omarmustafa130/Logic-Controlled-LED-Driver-PCB/Screenshots/Screenshot 2025-03-14 121610.png

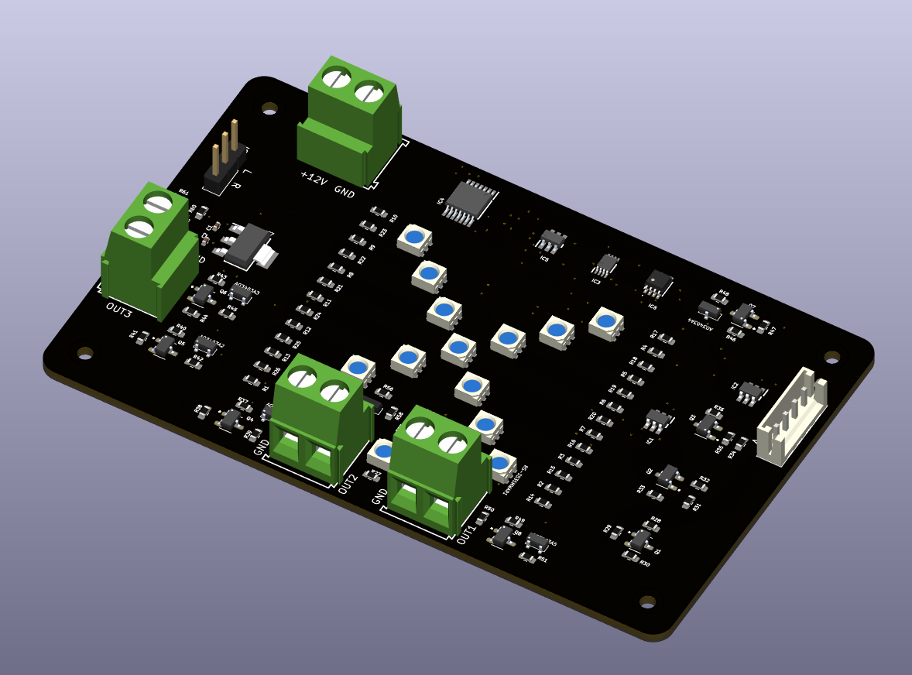
Screenshots/Screenshot 2025-03-14 121610.png
