omarmustafa130/Logic-Controlled-LED-Driver-PCB/Additional footprints, symbols, & 3D models/3D models/smd-3535rgb-led-1.snapshot.3/2.JPG

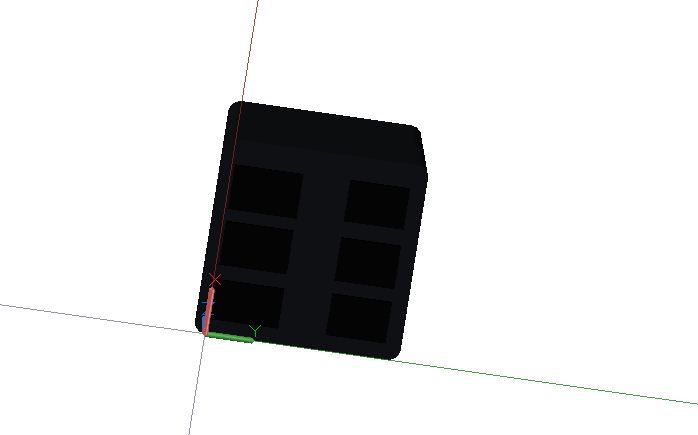
Additional footprints, symbols, & 3D models/3D models/smd-3535rgb-led-1.snapshot.3/2.JPG
