omarmustafa130/Logic-Controlled-LED-Driver-PCB/Additional footprints, symbols, & 3D models/3D models/smd_3535rgb_led_6_pin_0314055144_texture_obj/smd_3535rgb_led_6_pin_0314055144_texture_obj/smd_3535rgb_led_6_pin_0314055144_texture.png

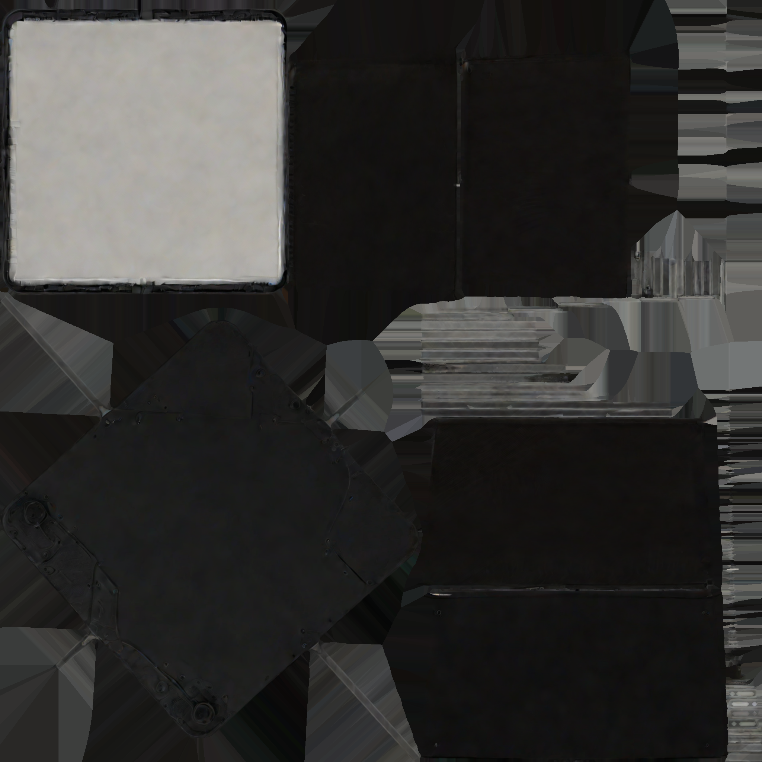
Additional footprints, symbols, & 3D models/3D models/smd_3535rgb_led_6_pin_0314055144_texture_obj/smd_3535rgb_led_6_pin_0314055144_texture_obj/smd_3535rgb_led_6_pin_0314055144_texture.png
