omarmustafa130/Logic-Controlled-LED-Driver-PCB/Fabrication Outputs/BOM/MOSFET Controller BOM.csv

# | Reference | Value | JLCPCB Part # | Package | Footprint | Description_1 | Datasheet | MANUFACTURER | Manufacturer_Name | Manufacturer_Part_Number | Mouser Part Number | Price
1 | AO3403A1 | AO3403A | C545577 | SOT-23-3 | MOSFET_CONTROLLER_LIB:AO3403A
2 | AO3403A2 | AO3403A | C545577 | SOT-23-3 | MOSFET_CONTROLLER_LIB:AO3403A
3 | AO3403A3 | AO3403A | C545577 | SOT-23-3 | MOSFET_CONTROLLER_LIB:AO3403A
4 | AO3403A4 | AO3403A | C545577 | SOT-23-3 | MOSFET_CONTROLLER_LIB:AO3403A
5 | AO3403A5 | AO3403A | C545577 | SOT-23-3 | MOSFET_CONTROLLER_LIB:AO3403A
6 | AO3403A6 | AO3403A | C545577 | SOT-23-3 | MOSFET_CONTROLLER_LIB:AO3403A
7 | AO3403A7 | AO3403A | C545577 | SOT-23-3 | MOSFET_CONTROLLER_LIB:AO3403A
8 | AO3403A8 | AO3403A | C545577 | SOT-23-3 | MOSFET_CONTROLLER_LIB:AO3403A
9 | C1 | 0.22u | C16651 | 402 | Capacitor_SMD:C_0402_1005Metric |  | ~
10 | C2 | 0.1u | C1525 | 402 | Capacitor_SMD:C_0402_1005Metric |  | ~
11 | IC1 | SN74LVC2G04DBVR | C10428 | SOT-23-6 | MOSFET_CONTROLLER_LIB:SOT95P280X145-6N |  | http://www.ti.com/lit/gpn/sn74lvc2g04 |  | Texas Instruments | SN74LVC2G04DBVR | 595-SN74LVC2G04DBVR
12 | IC2 | SN74LVC2G04DBVR | C10428 | SOT-23-6 | MOSFET_CONTROLLER_LIB:SOT95P280X145-6N |  | http://www.ti.com/lit/gpn/sn74lvc2g04 |  | Texas Instruments | SN74LVC2G04DBVR | 595-SN74LVC2G04DBVR
13 | IC3 | SN74LVC2G32DCUR | C91874 | VSSOP-8-0.5mm | MOSFET_CONTROLLER_LIB:SOP50P310X90-8N |  | https://www.ti.com/lit/ds/symlink/sn74lvc2g32.pdf?ts=1619327696294 |  | Texas Instruments | SN74LVC2G32DCURG4 | 595-74LVC2G32DCURG4
14 | IC4 | CD74HCT11M96 | C6553 | SOIC-14 | SOIC127P600X175-14N |  | http://www.ti.com/lit/gpn/cd74hct11 |  | Texas Instruments | CD74HCT11M96 | 595-CD74HCT11M96
15 | IC5 | SN74LVC1G11DCKR | C529281 | SC-70-6 | MOSFET_CONTROLLER_LIB:SOT95P275X110-6N |  | https://www.onsemi.com/pub/Collateral/NL17SZ11-D.PDF |  | onsemi | NL17SZ11DBVT1G | 863-NL17SZ11DBVT1G
16 | IC6 | TC7WH08FU,LJ(CT | C2880450 | SSOP-8-2.8mm | MOSFET_CONTROLLER_LIB:TC7W53FUF |  | https://toshiba.semicon-storage.com/info/docget.jsp?did=20199&prodName=TC7W08FU |  | Toshiba | TC7W08FU | 757-TC7W08FU
17 | IC7 | LM7805MPX/NOPB | C2848241 | SOT-223-4 | MOSFET_CONTROLLER_LIB:SOT230P700X180-4N |  | https://www.arrow.com/en/products/lm7805mpxnopb/texas-instruments |  | Texas Instruments | LM7805MPX/NOPB | 595-LM7805MPX/NOPB
18 | J1 | B4B-XH-A(LF)(SN) | C144395 | Plugin,P=2.5mm | MOSFET_CONTROLLER_LIB:SHDRV4W111P0_250_1X4_1250X380X600P |  | https://datasheet.datasheetarchive.com/originals/distributors/Datasheets_SAMA/4db6e353008cd822f9644e9913ed09f5.pdf |  | JST (JAPAN SOLDERLESS TERMINALS) | B4B-EH-A(LF)(SN) | 306-B4BEHALFSN
19 | J2 | WJ127-5.0-2P | C3703 | Plugin,P=5mm | MOSFET_CONTROLLER_LIB:691216510002S | 2 Position Wire to Board Terminal Block Horizontal with Board 0.200 (5.08mm) Through Hole |  |  |  |  |  | None
20 | J3 | WJ127-5.0-2P | C3703 | Plugin,P=5mm | MOSFET_CONTROLLER_LIB:691216510002S | 2 Position Wire to Board Terminal Block Horizontal with Board 0.200 (5.08mm) Through Hole |  |  |  |  |  | None
21 | J4 | WJ127-5.0-2P | C3703 | Plugin,P=5mm | MOSFET_CONTROLLER_LIB:691216510002S | 2 Position Wire to Board Terminal Block Horizontal with Board 0.200 (5.08mm) Through Hole |  |  |  |  |  | None
22 | J5 | Conn_01x03_Pin | C49257 | Plugin,P=5mm | Connector_PinHeader_2.54mm:PinHeader_1x03_P2.54mm_Vertical |  | ~
23 | J6 | WJ127-5.0-2P | C3703 | Plugin,P=5mm | MOSFET_CONTROLLER_LIB:691216510002S | 2 Position Wire to Board Terminal Block Horizontal with Board 0.200 (5.08mm) Through Hole |  |  |  |  |  | None
24 | R1 | 100R | C22775 | 603 | Resistor_SMD:R_0603_1608Metric |  | ~
25 | R2 | 100R | C22775 | 603 | Resistor_SMD:R_0603_1608Metric |  | ~
26 | R3 | 100R | C22775 | 603 | Resistor_SMD:R_0603_1608Metric |  | ~
27 | R4 | 100R | C22775 | 603 | Resistor_SMD:R_0603_1608Metric |  | ~
28 | R5 | 100R | C22775 | 603 | Resistor_SMD:R_0603_1608Metric |  | ~
29 | R6 | 100R | C22775 | 603 | Resistor_SMD:R_0603_1608Metric |  | ~
30 | R7 | 100R | C22775 | 603 | Resistor_SMD:R_0603_1608Metric |  | ~
31 | R8 | 100R | C22775 | 603 | Resistor_SMD:R_0603_1608Metric |  | ~
32 | R9 | 100R | C22775 | 603 | Resistor_SMD:R_0603_1608Metric |  | ~
33 | R10 | 100R | C22775 | 603 | Resistor_SMD:R_0603_1608Metric |  | ~
34 | R11 | 100R | C22775 | 603 | Resistor_SMD:R_0603_1608Metric |  | ~
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
93 | RS-3535MWAR7 | RS-3535MWAR | C110402 | SMD3535 | MOSFET_CONTROLLER_LIB:RS-3535MWAR
94 | RS-3535MWAR8 | RS-3535MWAR | C110402 | SMD3535 | MOSFET_CONTROLLER_LIB:RS-3535MWAR
95 | RS-3535MWAR9 | RS-3535MWAR | C110402 | SMD3535 | MOSFET_CONTROLLER_LIB:RS-3535MWAR
96 | RS-3535MWAR10 | RS-3535MWAR | C110402 | SMD3535 | MOSFET_CONTROLLER_LIB:RS-3535MWAR
97 | RS-3535MWAR11 | RS-3535MWAR | C110402 | SMD3535 | MOSFET_CONTROLLER_LIB:RS-3535MWAR
98 | RS-3535MWAR12 | RS-3535MWAR | C110402 | SMD3535 | MOSFET_CONTROLLER_LIB:RS-3535MWAR
99 | RS-3535MWAR13 | RS-3535MWAR | C110402 | SMD3535 | MOSFET_CONTROLLER_LIB:RS-3535MWAR
100 | RS-3535MWAR14 | RS-3535MWAR | C110402 | SMD3535 | MOSFET_CONTROLLER_LIB:RS-3535MWAR
101 | Q1 | AO3400A | C20917 | SOT-23-3L | MOSFET_CONTROLLER_LIB:AO3403A | N-Channel 30 V 5.7A (Ta) 1.4W (Ta) Surface Mount SOT-23-3 |  | Alpha & Omega Semiconductor |  |  |  | None
102 | Q2 | AO3400A | C20917 | SOT-23-3L | MOSFET_CONTROLLER_LIB:AO3403A | N-Channel 30 V 5.7A (Ta) 1.4W (Ta) Surface Mount SOT-23-3 |  | Alpha & Omega Semiconductor |  |  |  | None
103 | Q3 | AO3400A | C20917 | SOT-23-3L | MOSFET_CONTROLLER_LIB:AO3403A | N-Channel 30 V 5.7A (Ta) 1.4W (Ta) Surface Mount SOT-23-3 |  | Alpha & Omega Semiconductor |  |  |  | None
104 | Q4 | AO3400A | C20917 | SOT-23-3L | MOSFET_CONTROLLER_LIB:AO3403A | N-Channel 30 V 5.7A (Ta) 1.4W (Ta) Surface Mount SOT-23-3 |  | Alpha & Omega Semiconductor |  |  |  | None
105 | Q5 | AO3400A | C20917 | SOT-23-3L | MOSFET_CONTROLLER_LIB:AO3403A | N-Channel 30 V 5.7A (Ta) 1.4W (Ta) Surface Mount SOT-23-3 |  | Alpha & Omega Semiconductor |  |  |  | None
106 | Q6 | AO3400A | C20917 | SOT-23-3L | MOSFET_CONTROLLER_LIB:AO3403A | N-Channel 30 V 5.7A (Ta) 1.4W (Ta) Surface Mount SOT-23-3 |  | Alpha & Omega Semiconductor |  |  |  | None
107 | Q7 | AO3400A | C20917 | SOT-23-3L | MOSFET_CONTROLLER_LIB:AO3403A | N-Channel 30 V 5.7A (Ta) 1.4W (Ta) Surface Mount SOT-23-3 |  | Alpha & Omega Semiconductor |  |  |  | None
108 | Q8 | AO3400A | C20917 | SOT-23-3L | MOSFET_CONTROLLER_LIB:AO3403A | N-Channel 30 V 5.7A (Ta) 1.4W (Ta) Surface Mount SOT-23-3 |  | Alpha & Omega Semiconductor |  |  |  | None
109 | Q9 | AO3400A | C20917 | SOT-23-3L | MOSFET_CONTROLLER_LIB:AO3403A | N-Channel 30 V 5.7A (Ta) 1.4W (Ta) Surface Mount SOT-23-3 |  | Alpha & Omega Semiconductor |  |  |  | None
110 | Q10 | AO3400A | C20917 | SOT-23-3L | MOSFET_CONTROLLER_LIB:AO3403A | N-Channel 30 V 5.7A (Ta) 1.4W (Ta) Surface Mount SOT-23-3 |  | Alpha & Omega Semiconductor |  |  |  | None
111 | Q11 | AO3400A | C20917 | SOT-23-3L | MOSFET_CONTROLLER_LIB:AO3403A | N-Channel 30 V 5.7A (Ta) 1.4W (Ta) Surface Mount SOT-23-3 |  | Alpha & Omega Semiconductor |  |  |  | None
