omarmustafa130/Logic-Controlled-LED-Driver-PCB/Additional footprints, symbols, & 3D models/3D models/smd_3535rgb_led_6_pin_0314055239_texture.stl

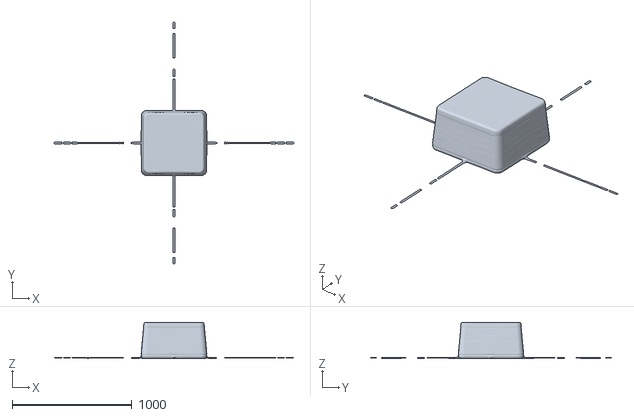
[picture p10: CAD file, 2025-03-16]
Additional footprints, symbols, & 3D models/3D models/smd_3535rgb_led_6_pin_0314055239_texture.stl
2004.7 x 2017.8 x 304.4
