omarmustafa130/Logic-Controlled-LED-Driver-PCB/Additional footprints, symbols, & 3D models/74HCT11PW/LIB_74HCT11PW,118/74HCT11PW,118/3D/74HCT11PW,118.stp

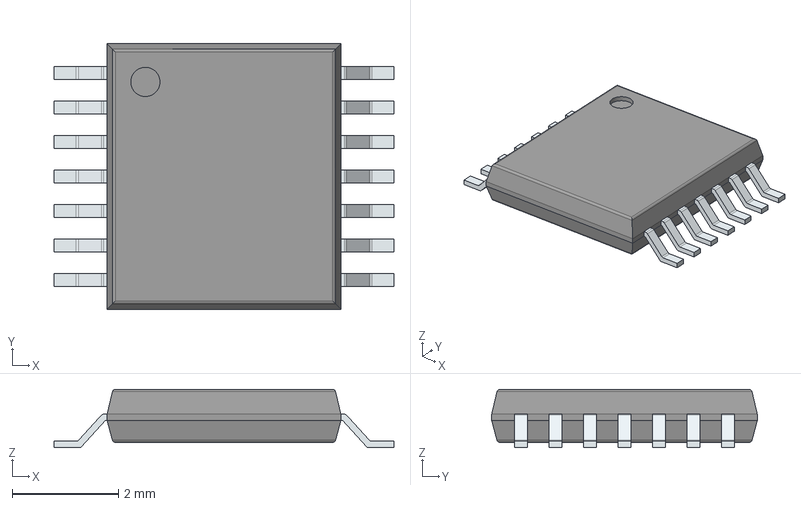
[picture p11: CAD file, 2025-03-16]
Additional footprints, symbols, & 3D models/74HCT11PW/LIB_74HCT11PW,118/74HCT11PW,118/3D/74HCT11PW,118.stp
6.40 x 5.00 x 1.10 mm
PinsArrayLR
