omarmustafa130/Logic-Controlled-LED-Driver-PCB/Additional footprints, symbols, & 3D models/7805/LIB_LM7805MPX_NOPB/LM7805MPX_NOPB/3D/LM7805MPX_NOPB.stp

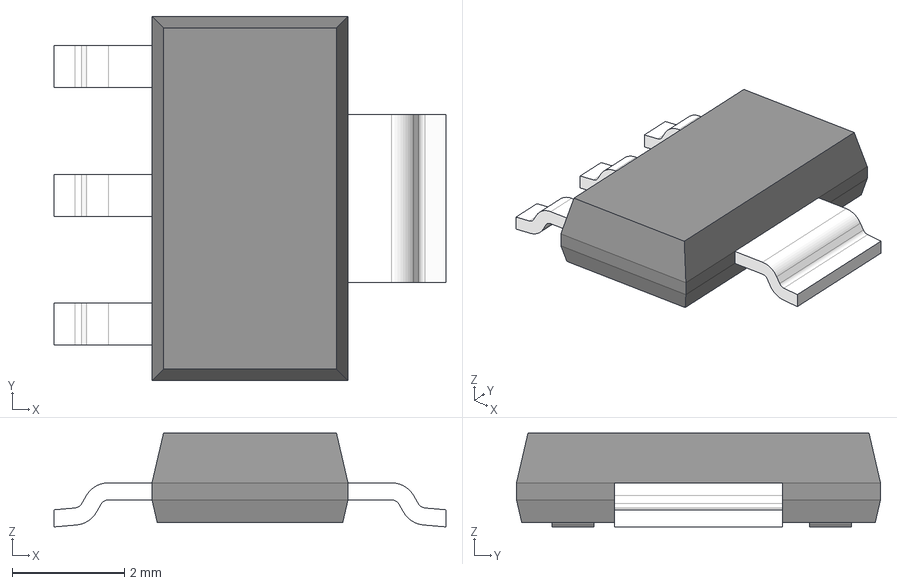
[picture p12: CAD file, 2025-03-16]
Additional footprints, symbols, & 3D models/7805/LIB_LM7805MPX_NOPB/LM7805MPX_NOPB/3D/LM7805MPX_NOPB.stp
7.00 x 6.50 x 1.68 mm
BODY-SOT
LEAD-SOT x 3
LEAD-SOT-WIDE
PIN1-ID
