omarmustafa130/Logic-Controlled-LED-Driver-PCB/Additional footprints, symbols, & 3D models/AO3400A/AO3400A/AO3400A.step

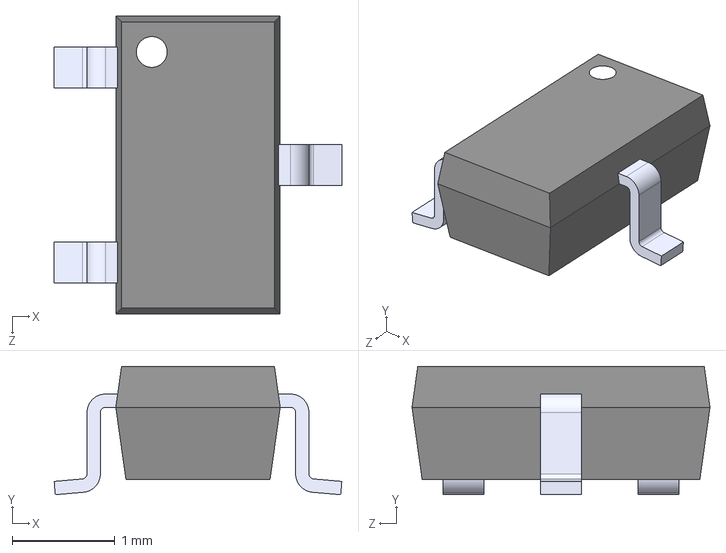
[picture p13: CAD file, 2025-03-16]
Additional footprints, symbols, & 3D models/AO3400A/AO3400A/AO3400A.step
2.80 x 1.25 x 2.90 mm
