omarmustafa130/Logic-Controlled-LED-Driver-PCB/Additional footprints, symbols, & 3D models/B4B-EH-A(LF)(SN)/LIB_B4B-EH-A_LF__SN_/B4B-EH-A_LF__SN_/3D/B4B-EH-A_LF__SN_.stp

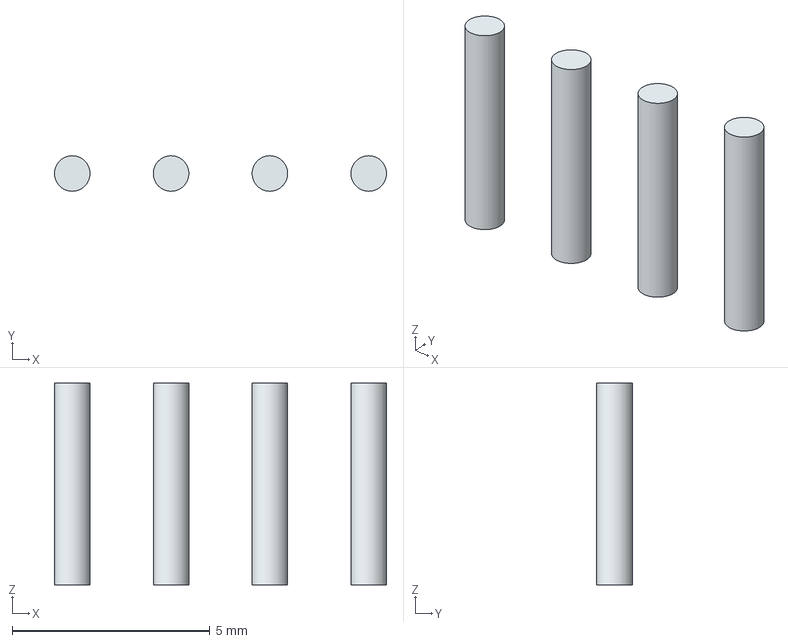
[picture p14: CAD file, 2025-03-16]
Additional footprints, symbols, & 3D models/B4B-EH-A(LF)(SN)/LIB_B4B-EH-A_LF__SN_/B4B-EH-A_LF__SN_/3D/B4B-EH-A_LF__SN_.stp
8.40 x 0.9 x 5.10 mm
Leads x 4
