omarmustafa130/Logic-Controlled-LED-Driver-PCB/Additional footprints, symbols, & 3D models/CD74HCT11M96/LIB_CD74HCT11M96/CD74HCT11M96/3D/CD74HCT11M96.stp

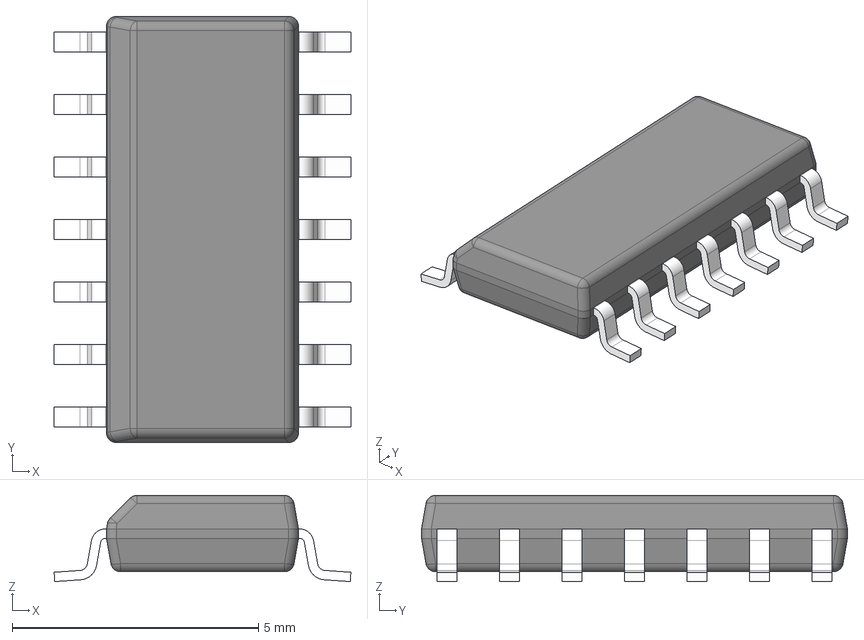
[picture p15: CAD file, 2025-03-16]
Additional footprints, symbols, & 3D models/CD74HCT11M96/LIB_CD74HCT11M96/CD74HCT11M96/3D/CD74HCT11M96.stp
6.03 x 8.65 x 1.75 mm
BODY-SO
LEAD-SO x 14
PIN1-ID
