omarmustafa130/Logic-Controlled-LED-Driver-PCB/Additional footprints, symbols, & 3D models/NL17SZ11DBVT1G/LIB_NL17SZ11DBVT1G/NL17SZ11DBVT1G/3D/NL17SZ11DBVT1G.stp

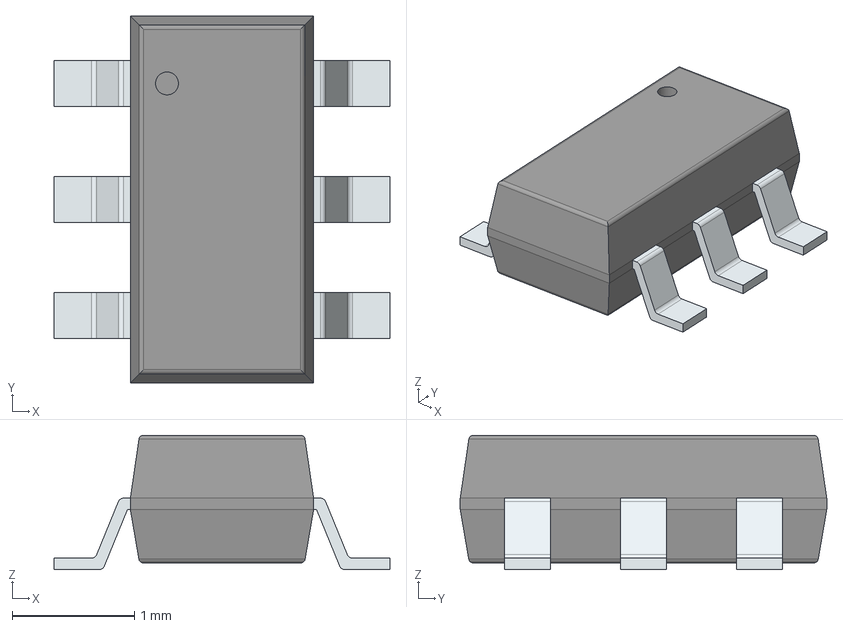
[picture p16: CAD file, 2025-03-16]
Additional footprints, symbols, & 3D models/NL17SZ11DBVT1G/LIB_NL17SZ11DBVT1G/NL17SZ11DBVT1G/3D/NL17SZ11DBVT1G.stp
2.75 x 3.00 x 1.10 mm
PinsArrayLR
