omarmustafa130/Logic-Controlled-LED-Driver-PCB/Additional footprints, symbols, & 3D models/SN74LVC2G04DBVR/LIB_SN74LVC2G04DBVR/SN74LVC2G04DBVR/3D/SN74LVC2G04DBVR.stp

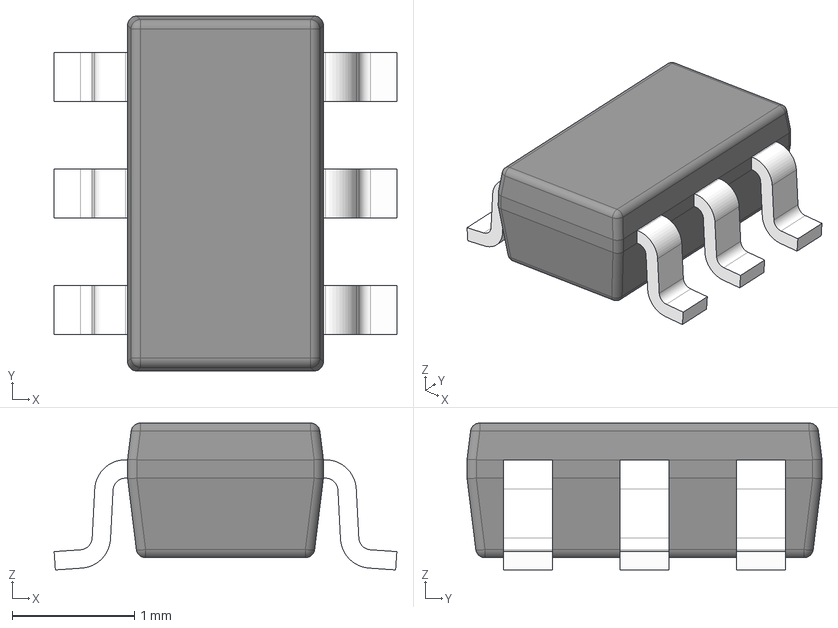
[picture p17: CAD file, 2025-03-16]
Additional footprints, symbols, & 3D models/SN74LVC2G04DBVR/LIB_SN74LVC2G04DBVR/SN74LVC2G04DBVR/3D/SN74LVC2G04DBVR.stp
2.80 x 2.90 x 1.20 mm
BODY-SOT
LEAD-SOT x 6
