omarmustafa130/Logic-Controlled-LED-Driver-PCB/Additional footprints, symbols, & 3D models/SN74LVC2G32DCURG4/LIB_SN74LVC2G32DCURG4/SN74LVC2G32DCURG4/3D/SN74LVC2G32DCURG4.stp

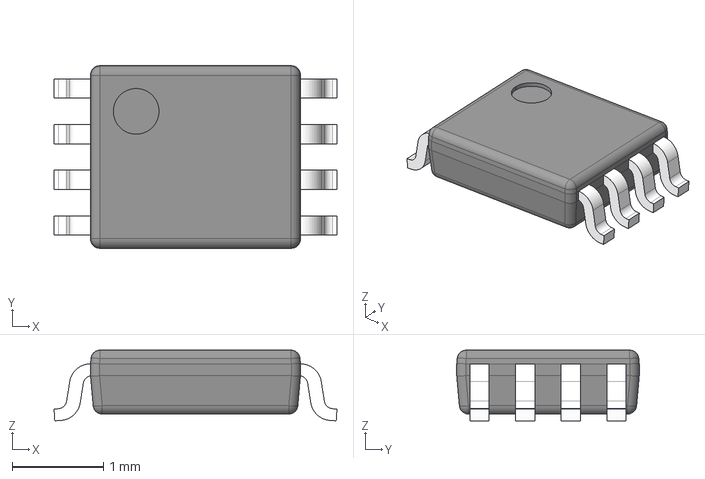
[picture p18: CAD file, 2025-03-16]
Additional footprints, symbols, & 3D models/SN74LVC2G32DCURG4/LIB_SN74LVC2G32DCURG4/SN74LVC2G32DCURG4/3D/SN74LVC2G32DCURG4.stp
3.10 x 2.00 x 0.775 mm
BODY-VSSOP
LEAD-VSSOP x 8
