omarmustafa130/Logic-Controlled-LED-Driver-PCB/Additional footprints, symbols, & 3D models/TC7W08FU/LIB_TC7W08FU/TC7W08FU/3D/TC7W08FU.stp

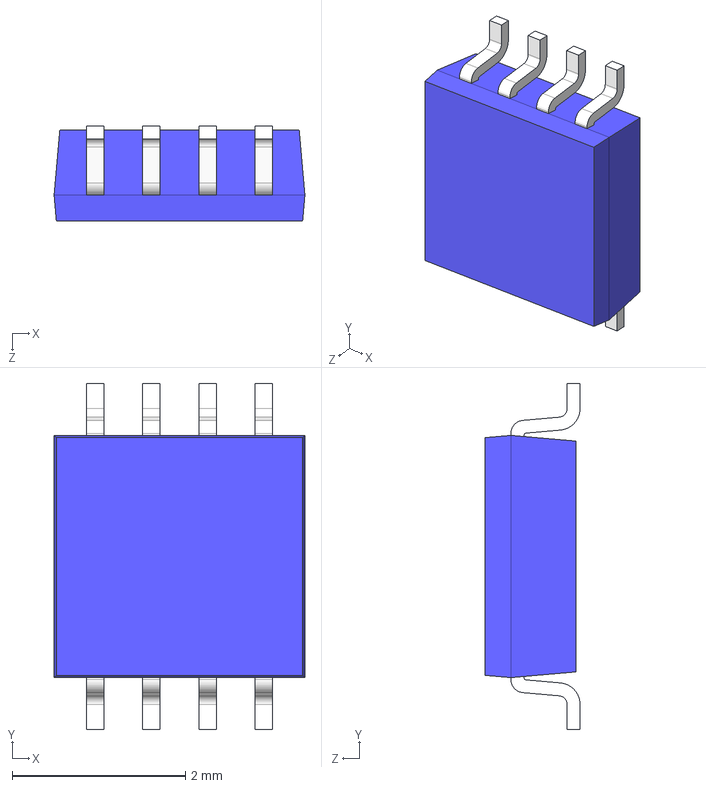
[picture p19: CAD file, 2025-03-16]
Additional footprints, symbols, & 3D models/TC7W08FU/LIB_TC7W08FU/TC7W08FU/3D/TC7W08FU.stp
2.90 x 4.00 x 1.10 mm
