omarmustafa130/Logic-Controlled-LED-Driver-PCB/Additional footprints, symbols, & 3D models/3D models/smd_3535rgb_led_6_pin_0314060435_texture.stl

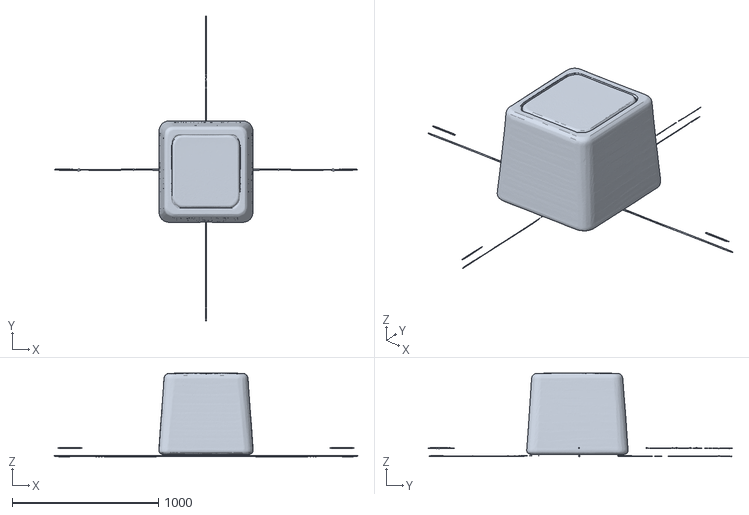
[picture p20: CAD file, 2025-03-16]
Additional footprints, symbols, & 3D models/3D models/smd_3535rgb_led_6_pin_0314060435_texture.stl
2080.1 x 2087.7 x 574.4
