omarmustafa130/Logic-Controlled-LED-Driver-PCB/Additional footprints, symbols, & 3D models/PCB Terminal Block/691216510002S/691216510002S.step

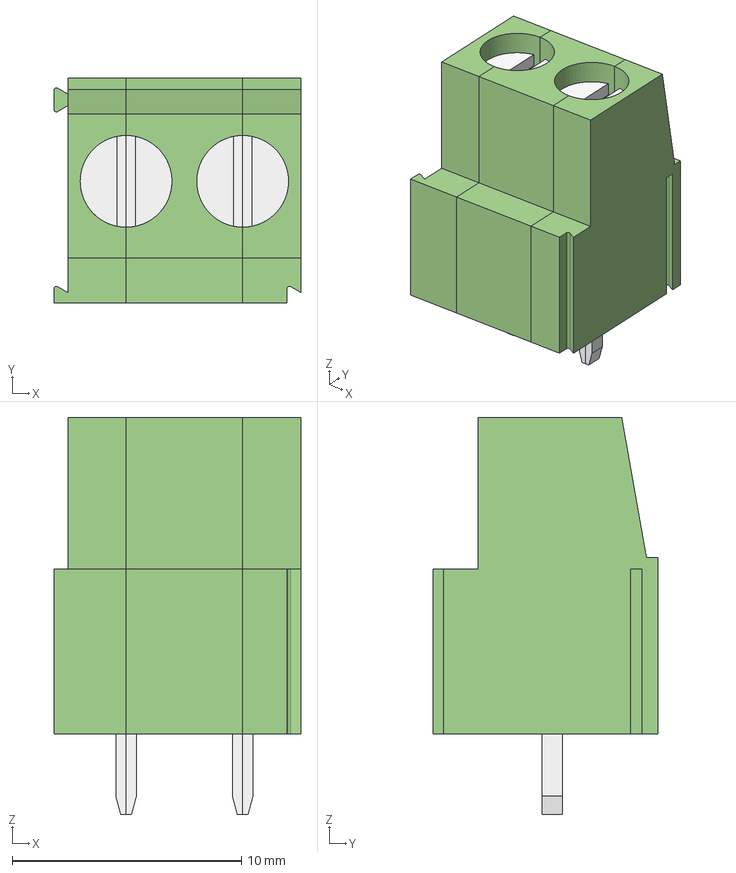
[picture p21: CAD file, 2025-03-16]
Additional footprints, symbols, & 3D models/PCB Terminal Block/691216510002S/691216510002S.step
10.8 x 9.80 x 17.3 mm
CLL5.08_DX
CLL5.08_CNT
CLL5.08_SX
