omarmustafa130/Logic-Controlled-LED-Driver-PCB/(list of files, cad)

Other CAD files:
Additional footprints, symbols, & 3D models/3D models/smd-3535rgb-led-1.snapshot.3/3535RGB.dwg
Additional footprints, symbols, & 3D models/74HCT11PW/LIB_74HCT11PW,118/74HCT11PW,118/Allegro/sop65p640x110-14n.psm
Additional footprints, symbols, & 3D models/74HCT11PW/LIB_74HCT11PW,118/74HCT11PW,118/DEHDL/74hct11pw_118/chips/chips.prt
Additional footprints, symbols, & 3D models/7805/LIB_LM7805MPX_NOPB/LM7805MPX_NOPB/Allegro/sot230p700x180-4n.psm
Additional footprints, symbols, & 3D models/7805/LIB_LM7805MPX_NOPB/LM7805MPX_NOPB/DEHDL/lm7805mpx_nopb/chips/chips.prt
Additional footprints, symbols, & 3D models/B4B-EH-A(LF)(SN)/LIB_B4B-EH-A_LF__SN_/B4B-EH-A_LF__SN_/Allegro/shdrv4w111p0_250_1x4_1250x380x600p.psm
Additional footprints, symbols, & 3D models/B4B-EH-A(LF)(SN)/LIB_B4B-EH-A_LF__SN_/B4B-EH-A_LF__SN_/DEHDL/b4b_eh_a_lf__sn_/chips/chips.prt
Additional footprints, symbols, & 3D models/CD74HCT11M96/LIB_CD74HCT11M96/CD74HCT11M96/Allegro/soic127p600x175-14n.psm
Additional footprints, symbols, & 3D models/CD74HCT11M96/LIB_CD74HCT11M96/CD74HCT11M96/DEHDL/cd74hct11m96/chips/chips.prt
Additional footprints, symbols, & 3D models/NL17SZ11DBVT1G/LIB_NL17SZ11DBVT1G/NL17SZ11DBVT1G/Allegro/sot95p275x110-6n.psm
Additional footprints, symbols, & 3D models/NL17SZ11DBVT1G/LIB_NL17SZ11DBVT1G/NL17SZ11DBVT1G/DEHDL/nl17sz11dbvt1g/chips/chips.prt
Additional footprints, symbols, & 3D models/SN74LVC2G04DBVR/LIB_SN74LVC2G04DBVR/SN74LVC2G04DBVR/Allegro/sot95p280x145-6n.psm
Additional footprints, symbols, & 3D models/SN74LVC2G04DBVR/LIB_SN74LVC2G04DBVR/SN74LVC2G04DBVR/DEHDL/sn74lvc2g04dbvr/chips/chips.prt
Additional footprints, symbols, & 3D models/SN74LVC2G32DCURG4/LIB_SN74LVC2G32DCURG4/SN74LVC2G32DCURG4/Allegro/sop50p310x90-8n.psm
Additional footprints, symbols, & 3D models/SN74LVC2G32DCURG4/LIB_SN74LVC2G32DCURG4/SN74LVC2G32DCURG4/DEHDL/sn74lvc2g32dcurg4/chips/chips.prt
Additional footprints, symbols, & 3D models/TC7W08FU/LIB_TC7W08FU/TC7W08FU/Allegro/tc7w53fuf.psm
Additional footprints, symbols, & 3D models/TC7W08FU/LIB_TC7W08FU/TC7W08FU/DEHDL/tc7w08fu/chips/chips.prt
