omarmustafa130/Logic-Controlled-LED-Driver-PCB/Schematics/Schematics.pdf

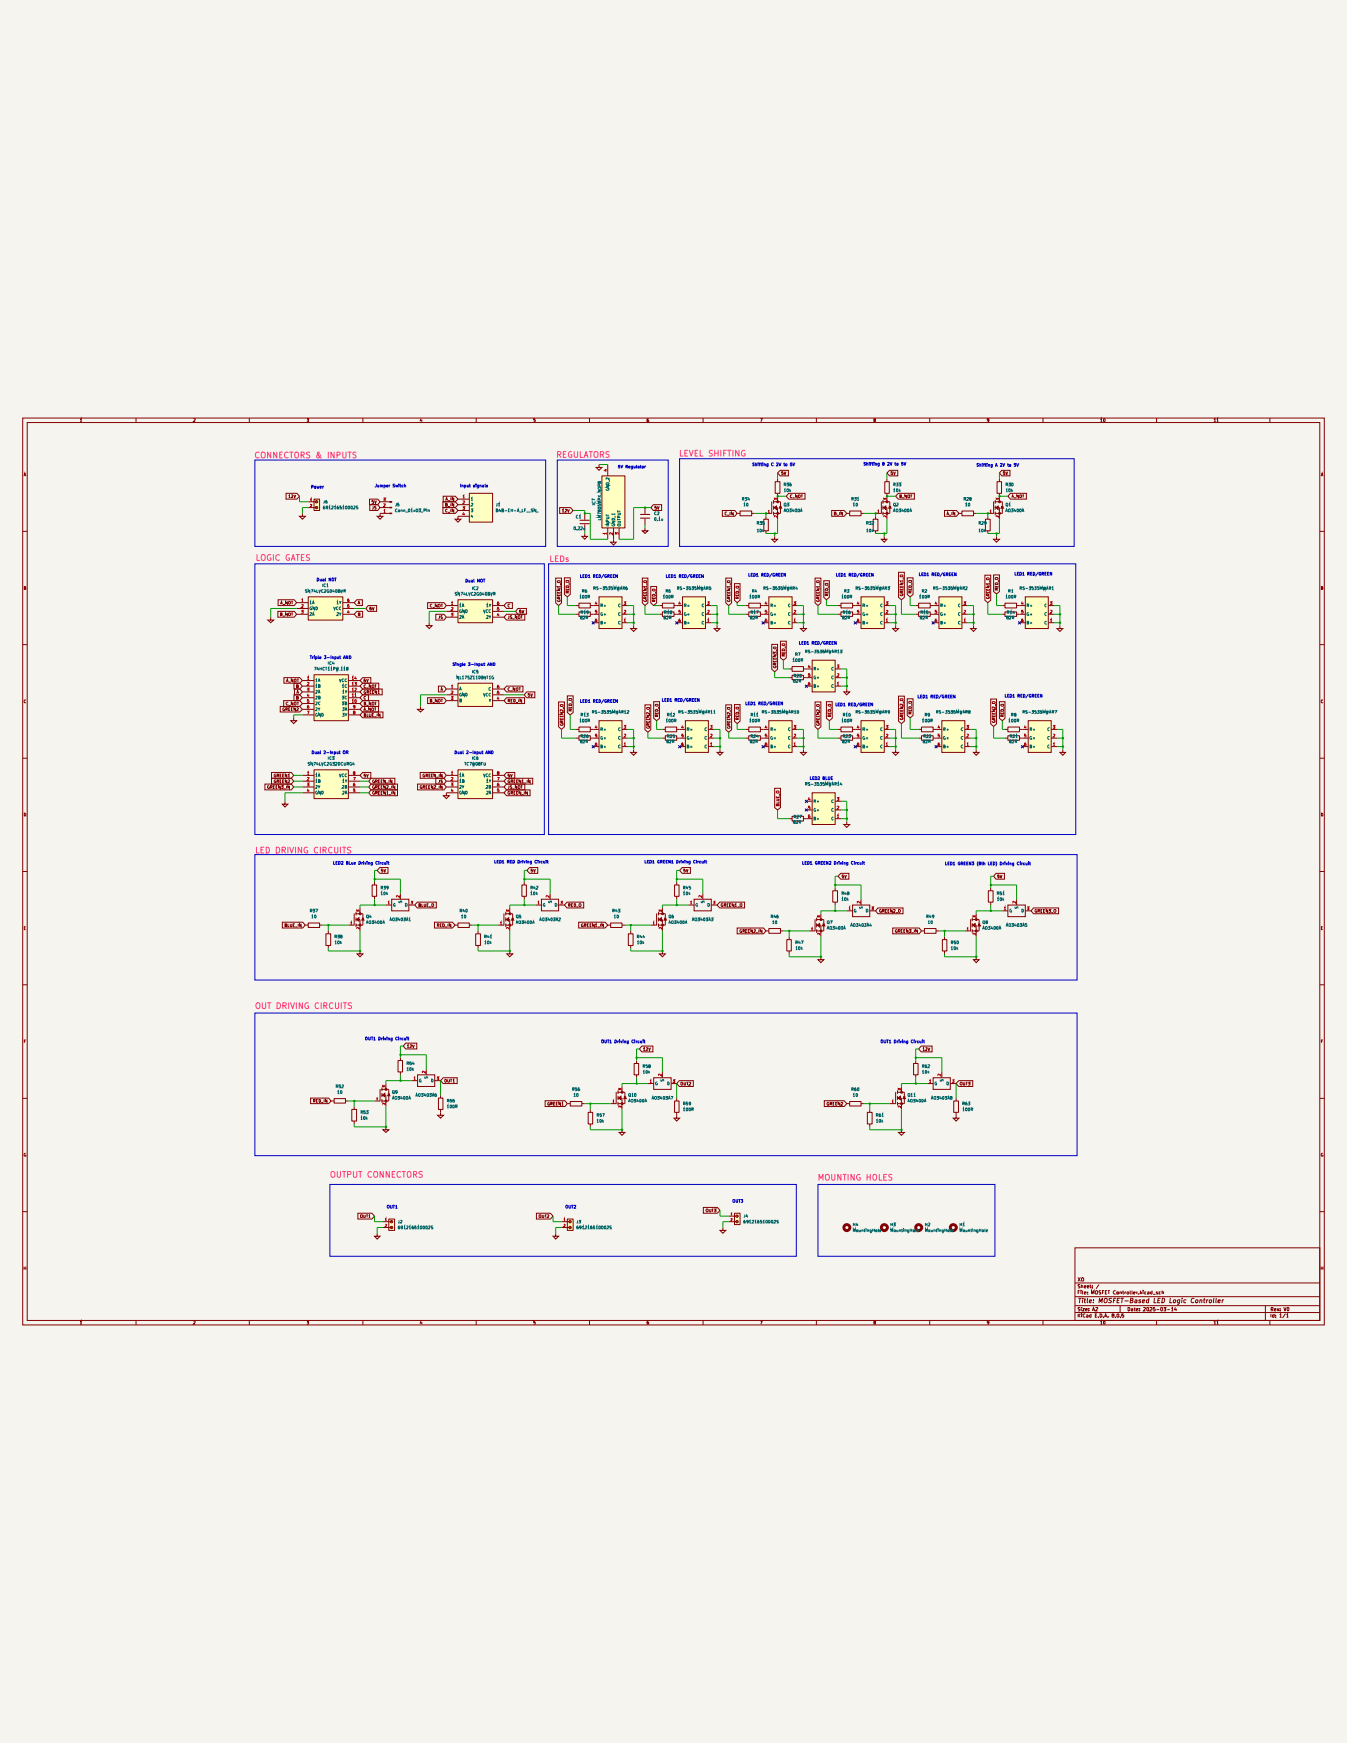
[picture p22: page 1]
