omarmustafa130/Logic-Controlled-LED-Driver-PCB/(list of files, drawings)

Other design files:
Simulation/MOSFET_CONTROLLER.pdsprj
Simulation/Project Backups/MOSFET_CONTROLLER [20250313, 23-41-58].pdsprj
Simulation/Project Backups/MOSFET_CONTROLLER [20250314, 00-18-40].pdsprj
Simulation/Project Backups/MOSFET_CONTROLLER [20250314, 00-28-29].pdsprj
Simulation/Project Backups/MOSFET_CONTROLLER [20250314, 00-48-38].pdsprj
Simulation/Project Backups/MOSFET_CONTROLLER [20250314, 01-27-56].pdsprj
Simulation/Project Backups/MOSFET_CONTROLLER [20250314, 04-41-20].pdsprj
Simulation/Project Backups/MOSFET_CONTROLLER [20250314, 09-30-05].pdsprj
Simulation/Project Backups/MOSFET_CONTROLLER [20250314, 09-30-11].pdsprj
Simulation/Project Backups/MOSFET_CONTROLLER [20250314, 10-53-27].pdsprj
Simulation/Project Backups/MOSFET_CONTROLLER [20250314, 11-33-43].pdsprj
