omarmustafa130/Logic-Controlled-LED-Driver-PCB/MOSFET Controller/MOSFET Controller.kicad_pcb

## KiCad design MOSFET Controller/MOSFET Controller.kicad_pcb (2025-03-16)

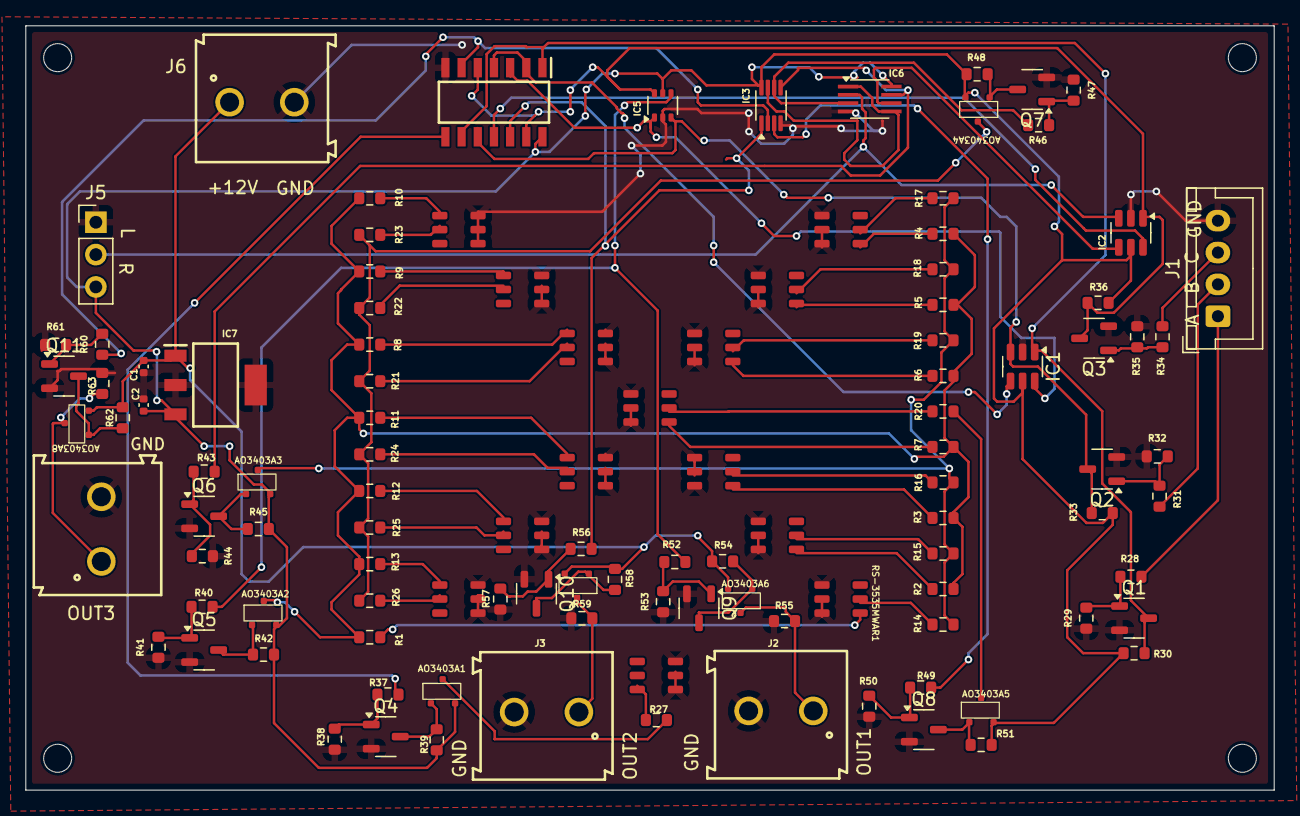
[picture p23: board MOSFET Controller.kicad_pcb from above]

Board: 2 copper layers, 98.0 x 60.0 mm, 115 parts (0 on the bottom side), 76 nets.

Parts:
AO3403A1, AO3403A2, AO3403A3, AO3403A4, AO3403A5, AO3403A6, AO3403A7, AO3403A8: AO3403A
C1: 0.22u; C_0402_1005Metric
C2: 0.1u; C_0402_1005Metric
H1, H2, H3, H4: MountingHole; MountingHole_2.2mm_M2
IC1, IC2: SN74LVC2G04DBVR; SOT-23-6
IC3: SN74LVC2G32DCURG4; VSSOP-8_2.3x2mm_P0.5mm
IC4: 74HCT11PW,118; SOIC127P600X175-14N - IC4
IC5: NL17SZ11DBVT1G; SOT-363_SC-70-6
IC6: TC7W08FU; SSOP-8_2.95x2.8mm_P0.65mm
IC7: LM7805MPX_NOPB; SOT230P700X180-4N
J1: B4B-EH-A_LF__SN_; JST_XH_B4B-XH-A_1x04_P2.50mm_Vertical
J2, J3, J4, J6: 691216510002S
J5: Conn_01x03_Pin; PinHeader_1x03_P2.54mm_Vertical
Q1, Q2, Q3, Q4, Q5, Q6, Q7, Q8, Q9, Q10, Q11: AO3400A; SOT-23-3
R1, R2, R3, R4, R5, R6, R7, R8, R9, R10, R11, R12, R13, R55, R59, R63: 100R; R_0603_1608Metric
R14, R15, R16, R17, R18, R19, R20, R21, R22, R23, R24, R25, R26, R27: 82R; R_0603_1608Metric
R28, R31, R34, R37, R40, R43, R46, R49, R52, R56, R60: 10; R_0603_1608Metric
R29, R30, R32, R33, R35, R36, R38, R39, R41, R42, R44, R45, R47, R48, R50, R51, R53, R54, R57, R58, R61, R62: 10k; R_0603_1608Metric
RS-3535MWAR1, RS-3535MWAR2, RS-3535MWAR3, RS-3535MWAR4, RS-3535MWAR5, RS-3535MWAR6, RS-3535MWAR7, RS-3535MWAR8, RS-3535MWAR9, RS-3535MWAR10, RS-3535MWAR11, RS-3535MWAR12, RS-3535MWAR13, RS-3535MWAR14: RS-3535MWAR

Connections:
5V: AO3403A1.2 (S), AO3403A2.2 (S), AO3403A3.2 (S), AO3403A4.2 (S), AO3403A5.2 (S), C2.1, IC1.5 (VCC), IC2.5 (VCC), IC3.8 (VCC), IC4.14 (VCC), IC5.5 (VCC), IC6.8 (VCC), IC7.3 (OUTPUT), J5.3, R30.2, R33.2, R36.2, R39.2, R42.2, R45.2, R48.2, R51.2
12V: AO3403A6.2 (S), AO3403A7.2 (S), AO3403A8.2 (S), C1.1, IC7.1 (INPUT), J6.1, R54.2, R58.2, R62.2
A: IC1.6 (1Y), IC4.3 (2A), IC5.1 (A)
A_IN: J1.1, R28.1
A_NOT: IC1.1 (1A), IC4.1 (1A), IC4.9 (3A), Q1.3, R30.1
B: IC1.4 (2Y), IC4.2 (1B), IC4.4 (2B)
BLUE_IN: IC4.8 (3Y), R37.1
BLUE_O: AO3403A1.3 (D), R27.1
B_IN: J1.2, R31.1
B_NOT: IC1.3 (2A), IC4.10 (3B), IC5.3 (B), Q2.3, R33.1
C: IC2.6 (1Y), IC4.11 (3C)
C_IN: J1.3, R34.1
C_NOT: IC2.1 (1A), IC4.5 (2C), IC4.13 (1C), IC5.6 (C), Q3.3, R36.1
GND: C1.2, C2.2, IC1.2 (GND), IC2.2 (GND), IC3.4 (GND), IC4.7 (GND), IC5.2 (GND), IC6.4 (GND), IC7.2 (GND_1), IC7.4 (GND_2), J1.4, J2.2, J3.2, J4.2, J5.1, J6.2, Q1.2, Q2.2, Q3.2, Q4.2, Q5.2, Q6.2, Q7.2, Q8.2, Q9.2, Q10.2, Q11.2, R29.1, R32.1, R35.1, R38.1, R41.1, R44.1, R47.1, R50.1, R53.1, R55.1, R57.1, R59.1, R61.1, R63.1, RS-3535MWAR1.1 (C), RS-3535MWAR1.2 (C), RS-3535MWAR1.3 (C), RS-3535MWAR2.1 (C), RS-3535MWAR2.2 (C), RS-3535MWAR2.3 (C), RS-3535MWAR3.1 (C), RS-3535MWAR3.2 (C), RS-3535MWAR3.3 (C), RS-3535MWAR4.1 (C), RS-3535MWAR4.2 (C), RS-3535MWAR4.3 (C), RS-3535MWAR5.1 (C), RS-3535MWAR5.2 (C), RS-3535MWAR5.3 (C), RS-3535MWAR6.1 (C), RS-3535MWAR6.2 (C), RS-3535MWAR6.3 (C), RS-3535MWAR7.1 (C), RS-3535MWAR7.2 (C), RS-3535MWAR7.3 (C), RS-3535MWAR8.1 (C), RS-3535MWAR8.2 (C), RS-3535MWAR8.3 (C), RS-3535MWAR9.1 (C), RS-3535MWAR9.2 (C), RS-3535MWAR9.3 (C), RS-3535MWAR10.1 (C), RS-3535MWAR10.2 (C), RS-3535MWAR10.3 (C), RS-3535MWAR11.1 (C), RS-3535MWAR11.2 (C), RS-3535MWAR11.3 (C), RS-3535MWAR12.1 (C), RS-3535MWAR12.2 (C), RS-3535MWAR12.3 (C), RS-3535MWAR13.1 (C), RS-3535MWAR13.2 (C), RS-3535MWAR13.3 (C), RS-3535MWAR14.1 (C), RS-3535MWAR14.2 (C), RS-3535MWAR14.3 (C)
GREEN1: IC3.1 (1A), IC4.12 (1Y), R56.1
GREEN1_IN: IC3.5 (2A), IC6.7 (1Y), R43.1
GREEN1_O: AO3403A3.3 (D), R14.1, R15.1, R16.1, R17.1, R18.1, R19.1
GREEN2: IC3.2 (1B), IC4.6 (2Y), R60.1
GREEN2_IN: IC3.6 (2B), IC6.3 (2Y), R46.1
GREEN2_O: AO3403A4.3 (D), R21.1, R22.1, R23.1, R24.1, R25.1, R26.1
GREEN3_IN: IC3.3 (2Y), R49.1
GREEN3_O: AO3403A5.3 (D), R20.1
GREEN_IN: IC3.7 (1Y), IC6.1 (1A), IC6.5 (2A)
JS: IC2.3 (2A), IC6.2 (1B), J5.2
JS_NOT: IC2.4 (2Y), IC6.6 (2B)
unnamed: AO3403A1.1 (G), Q4.3, R39.1
unnamed: AO3403A2.1 (G), Q5.3, R42.1
unnamed: AO3403A3.1 (G), Q6.3, R45.1
unnamed: AO3403A4.1 (G), Q7.3, R48.1
unnamed: AO3403A5.1 (G), Q8.3, R51.1
unnamed: AO3403A6.1 (G), Q9.3, R54.1
unnamed: AO3403A7.1 (G), Q10.3, R58.1
unnamed: AO3403A8.1 (G), Q11.3, R62.1
unnamed: Q1.1, R28.2, R29.2
unnamed: Q2.1, R31.2, R32.2
unnamed: Q3.1, R34.2, R35.2
unnamed: Q4.1, R37.2, R38.2
unnamed: Q5.1, R40.2, R41.2
unnamed: Q6.1, R43.2, R44.2
unnamed: Q7.1, R46.2, R47.2
unnamed: Q8.1, R49.2, R50.2
unnamed: Q9.1, R52.2, R53.2
unnamed: Q10.1, R56.2, R57.2
unnamed: Q11.1, R60.2, R61.2
unnamed: R14.2, RS-3535MWAR1.5 (G+)
unnamed: R1.2, RS-3535MWAR1.4 (R+)
unnamed: R15.2, RS-3535MWAR2.5 (G+)
unnamed: R2.2, RS-3535MWAR2.4 (R+)
unnamed: R16.2, RS-3535MWAR3.5 (G+)
unnamed: R3.2, RS-3535MWAR3.4 (R+)
unnamed: R17.2, RS-3535MWAR4.5 (G+)
unnamed: R4.2, RS-3535MWAR4.4 (R+)
unnamed: R18.2, RS-3535MWAR5.5 (G+)
unnamed: R5.2, RS-3535MWAR5.4 (R+)
unnamed: R19.2, RS-3535MWAR6.5 (G+)
unnamed: R6.2, RS-3535MWAR6.4 (R+)
unnamed: R21.2, RS-3535MWAR7.5 (G+)
unnamed: R8.2, RS-3535MWAR7.4 (R+)
unnamed: R22.2, RS-3535MWAR8.5 (G+)
unnamed: R9.2, RS-3535MWAR8.4 (R+)
unnamed: R23.2, RS-3535MWAR9.5 (G+)
unnamed: R10.2, RS-3535MWAR9.4 (R+)
unnamed: R24.2, RS-3535MWAR10.5 (G+)
unnamed: R11.2, RS-3535MWAR10.4 (R+)
unnamed: R25.2, RS-3535MWAR11.5 (G+)
unnamed: R12.2, RS-3535MWAR11.4 (R+)
unnamed: R26.2, RS-3535MWAR12.5 (G+)
unnamed: R13.2, RS-3535MWAR12.4 (R+)
unnamed: R20.2, RS-3535MWAR13.5 (G+)
unnamed: R7.2, RS-3535MWAR13.4 (R+)
unnamed: R27.2, RS-3535MWAR14.6 (B+)
OUT1: AO3403A6.3 (D), J2.1, R55.2
OUT2: AO3403A7.3 (D), J3.1, R59.2
OUT3: AO3403A8.3 (D), J4.1, R63.2
RED_IN: IC5.4 (Y), R40.1, R52.1
RED_O: AO3403A2.3 (D), R1.1, R2.1, R3.1, R4.1, R5.1, R6.1, R7.1, R8.1, R9.1, R10.1, R11.1, R12.1, R13.1
